jaimevillegas/fusilera-rolo/fusilera 24 canales.kicad_pcb

## KiCad design fusilera 24 canales.kicad_pcb (2026-10-30)

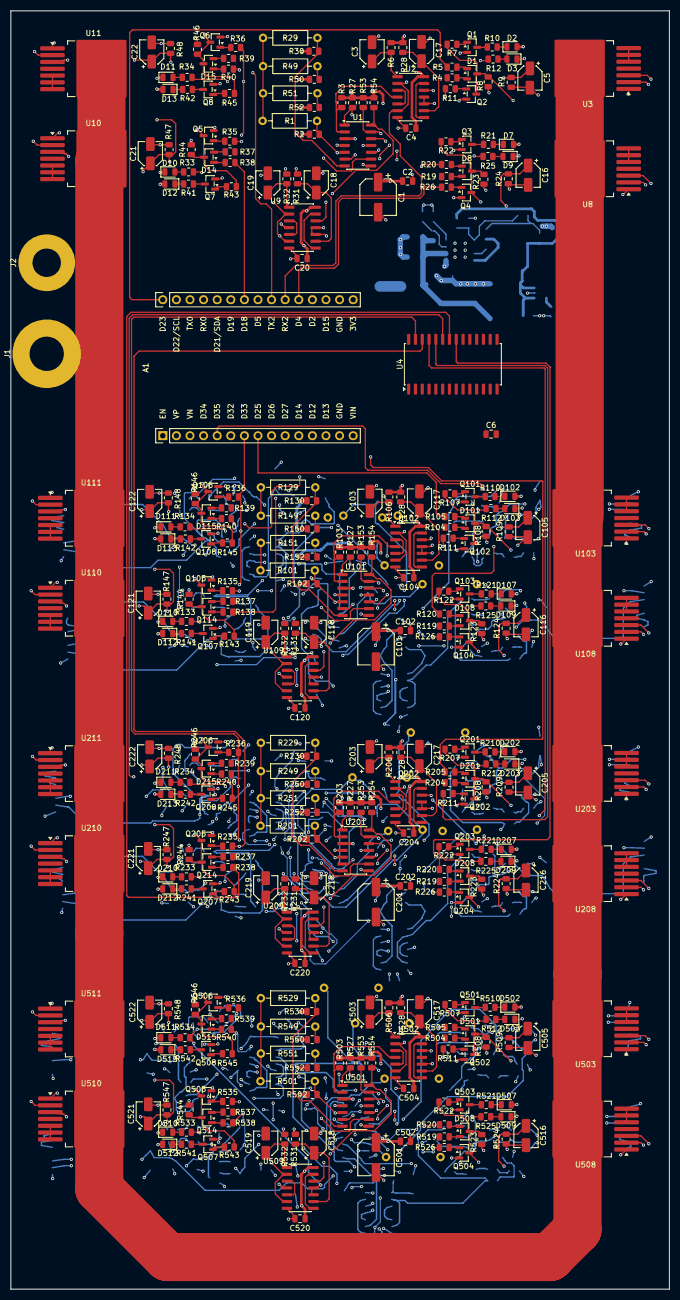
[picture p1: board fusilera 24 canales.kicad_pcb from above]

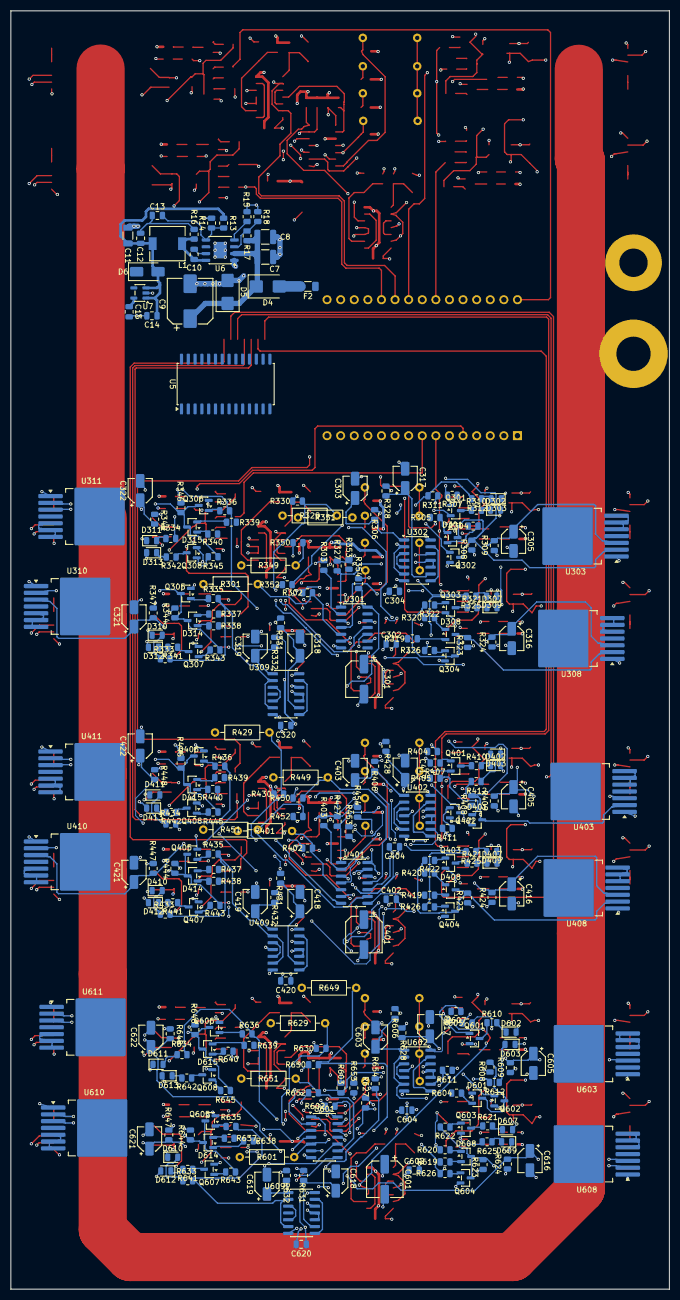
[picture p2: board fusilera 24 canales.kicad_pcb from below]

Board: 4 copper layers, 123.0 x 238.8 mm, 637 parts (284 on the bottom side), 446 nets.

Parts:
A1: ESP32 DevKit V1 30 pines; ESP32_DevKit_30pin_Socket
C1, C101, C201, C301, C401, C501, C601: 100uF 16V; CP_Elec_6.3x5.4
C2, C4, C6, C20, C102, C104, C120, C202, C204, C220, C302, C304, C320, C402, C404, C420, C502, C504, C520, C602, C604, C620: 100nF; C_0805_2012Metric
C3, C5, C16, C17, C18, C19, C21, C22, C103, C105, C116, C117, C118, C119, C121, C122, C203, C205, C216, C217, C218, C219, C221, C222, C303, C305, C316, C317, C318, C319, C321, C322, C403, C405, C416, C417, C418, C419, C421, C422, C503, C505, C516, C517, C518, C519, C521, C522, C603, C605, C616, C617, C618, C619, C621, C622: 1uF 25V; CP_Elec_4x5.4
C7, C8: 2.2uF 100V X7R; C_1210_3225Metric
C9: 47uF 50V; CP_Elec_8x10
C10: 2.2nF 50V X7R; C_0805_2012Metric
C11: 22uF 16V X7R; C_1206_3216Metric
C12: 1nF; C_0805_2012Metric
C13: 82pF C0G; C_0805_2012Metric
C14, C15: 1uF; C_0805_2012Metric
D1, D8, D14, D15, D101, D108, D114, D115, D201, D208, D214, D215, D301, D308, D314, D315, D401, D408, D414, D415, D501, D508, D514, D515, D601, D608, D614, D615: BAT54C; SOT-23
D2, D7, D12, D13, D102, D107, D112, D113, D202, D207, D212, D213, D302, D307, D312, D313, D402, D407, D412, D413, D502, D507, D512, D513, D602, D607, D612, D613: LED verde; LED_0805_2012Metric
D3, D9, D10, D11, D103, D109, D110, D111, D203, D209, D210, D211, D303, D309, D310, D311, D403, D409, D410, D411, D503, D509, D510, D511, D603, D609, D610, D611: LED rojo; LED_0805_2012Metric
D4: SS36; D_SMB
D5: SMBJ; D_SMB
D6: Schottky 1A (SS14); D_SMA
F2: 2A; Fuse_1206_3216Metric
J1: +12V borne M6; MountingHole_6.4mm_M6_Pad
J2: GND borne M5; MountingHole_5.3mm_M5_Pad
L1: 22uH; L_6.3x6.3_H3
Q1, Q2, Q3, Q4, Q5, Q6, Q7, Q8, Q101, Q102, Q103, Q104, Q105, Q106, Q107, Q108, Q201, Q202, Q203, Q204, Q205, Q206, Q207, Q208, Q301, Q302, Q303, Q304, Q305, Q306, Q307, Q308, Q401, Q402, Q403, Q404, Q405, Q406, Q407, Q408, Q501, Q502, Q503, Q504, Q505, Q506, Q507, Q508, Q601, Q602, Q603, Q604, Q605, Q606, Q607, Q608: MMBT2222A; SOT-23
R1, R29, R49, R51, R101, R129, R149, R151, R201, R229, R249, R251, R301, R329, R349, R351, R401, R429, R449, R451, R501, R529, R549, R551, R601, R629, R649, R651: umbral; R_Axial_DIN0207_L6.3mm_D2.5mm_P10.16mm_Horizontal
R2, R3, R6, R27, R28, R30, R31, R32, R50, R52, R53, R54, R102, R103, R106, R127, R128, R130, R131, R132, R150, R152, R153, R154, R202, R203, R206, R227, R228, R230, R231, R232, R250, R252, R253, R254, R302, R303, R306, R327, R328, R330, R331, R332, R350, R352, R353, R354, R402, R403, R406, R427, R428, R430, R431, R432, R450, R452, R453, R454, R502, R503, R506, R527, R528, R530, R531, R532, R550, R552, R553, R554, R602, R603, R606, R627, R628, R630, R631, R632, R650, R652, R653, R654: 10k; R_0805_2012Metric
R4, R5, R11, R19, R20, R26, R35, R36, R37, R38, R39, R40, R104, R105, R111, R119, R120, R126, R135, R136, R137, R138, R139, R140, R204, R205, R211, R219, R220, R226, R235, R236, R237, R238, R239, R240, R304, R305, R311, R319, R320, R326, R335, R336, R337, R338, R339, R340, R404, R405, R411, R419, R420, R426, R435, R436, R437, R438, R439, R440, R504, R505, R511, R519, R520, R526, R535, R536, R537, R538, R539, R540, R604, R605, R611, R619, R620, R626, R635, R636, R637, R638, R639, R640: 4.7k; R_0805_2012Metric
R7, R8, R22, R23, R43, R44, R45, R46, R107, R108, R122, R123, R143, R144, R145, R146, R207, R208, R222, R223, R243, R244, R245, R246, R307, R308, R322, R323, R343, R344, R345, R346, R407, R408, R422, R423, R443, R444, R445, R446, R507, R508, R522, R523, R543, R544, R545, R546, R607, R608, R622, R623, R643, R644, R645, R646: 100k; R_0805_2012Metric
R9, R12, R24, R25, R33, R34, R47, R48, R109, R112, R124, R125, R133, R134, R147, R148, R209, R212, R224, R225, R233, R234, R247, R248, R309, R312, R324, R325, R333, R334, R347, R348, R409, R412, R424, R425, R433, R434, R447, R448, R509, R512, R524, R525, R533, R534, R547, R548, R609, R612, R624, R625, R633, R634, R647, R648: 1k; R_0805_2012Metric
R10, R21, R41, R42, R110, R121, R141, R142, R210, R221, R241, R242, R310, R321, R341, R342, R410, R421, R441, R442, R510, R521, R541, R542, R610, R621, R641, R642: 2.2k; R_0805_2012Metric
R13: 301k; R_0805_2012Metric
R14: 95.3k; R_0805_2012Metric
R15: 31.6k; R_0805_2012Metric
R16: 390k; R_0805_2012Metric
R17: 1M; R_0805_2012Metric
R18: 270k; R_0805_2012Metric
U1, U101, U201, U301, U401, U501, U601: LM339D; SOIC-14_3.9x8.7mm_P1.27mm
U2, U9, U102, U109, U202, U209, U302, U309, U402, U409, U502, U509, U602, U609: 74HC132D; SOIC-14_3.9x8.7mm_P1.27mm
U3, U8, U10, U11, U103, U108, U110, U111, U203, U208, U210, U211, U303, U308, U310, U311, U403, U408, U410, U411, U503, U508, U510, U511, U603, U608, U610, U611: BTS50010-1TAD; TO-263-7_TabPin4
U4, U5: MCP23017-E/SO; SOIC-28W_7.5x17.9mm_P1.27mm
U6: LM5164DDA; HSOP-8-1EP_3.9x4.9mm_P1.27mm_EP2.41x3.1mm
U7: AP2112K-3.3; SOT-23-5

Connections:
+3.3V: C1.1, C2.1, C4.1, C20.1, C101.1, C102.1, C104.1, C120.1, C201.1, C202.1, C204.1, C220.1, C301.1, C302.1, C304.1, C320.1, C401.1, C402.1, C404.1, C420.1, C501.1, C502.1, C504.1, C520.1, C601.1, C602.1, C604.1, C620.1, D2.2 (A), D7.2 (A), D12.2 (A), D13.2 (A), D102.2 (A), D107.2 (A), D112.2 (A), D113.2 (A), D202.2 (A), D207.2 (A), D212.2 (A), D213.2 (A), D302.2 (A), D307.2 (A), D312.2 (A), D313.2 (A), D402.2 (A), D407.2 (A), D412.2 (A), D413.2 (A), D502.2 (A), D507.2 (A), D512.2 (A), D513.2 (A), D602.2 (A), D607.2 (A), D612.2 (A), D613.2 (A), R2.1, R3.2, R6.2, R27.2, R28.2, R30.1, R31.2, R32.2, R50.1, R52.1, R53.2, R54.2, R102.1, R103.2, R106.2, R127.2, R128.2, R130.1, R131.2, R132.2, R150.1, R152.1, R153.2, R154.2, R202.1, R203.2, R206.2, R227.2, R228.2, R230.1, R231.2, R232.2, R250.1, R252.1, R253.2, R254.2, R302.1, R303.2, R306.2, R327.2, R328.2, R330.1, R331.2, R332.2, R350.1, R352.1, R353.2, R354.2, R402.1, R403.2, R406.2, R427.2, R428.2, R430.1, R431.2, R432.2, R440.2, R450.1, R452.1, R453.2, R454.2, R502.1, R503.2, R505.2, R506.2, R520.2, R527.2, R528.2, R530.1, R531.2, R532.2, R538.2, R540.2, R550.1, R552.1, R553.2, R554.2, R602.1, R603.2, R605.2, R606.2, R620.2, R627.2, R628.2, R630.1, R631.2, R632.2, R638.2, R640.2, R650.1, R652.1, R653.2, R654.2, U1.3 (V+), U2.14 (VCC), U9.14 (VCC), U101.3 (V+), U102.14 (VCC), U109.14 (VCC), U201.3 (V+), U202.14 (VCC), U209.14 (VCC), U301.3 (V+), U302.14 (VCC), U309.14 (VCC), U401.3 (V+), U402.14 (VCC), U409.14 (VCC), U501.3 (V+), U502.14 (VCC), U509.14 (VCC), U601.3 (V+), U602.14 (VCC), U609.14 (VCC)
+12V: U3.4 (Vbb), U8.4 (Vbb), U10.4 (Vbb), U11.4 (Vbb), U103.4 (Vbb), U108.4 (Vbb), U110.4 (Vbb), U111.4 (Vbb), U203.4 (Vbb), U208.4 (Vbb), U210.4 (Vbb), U211.4 (Vbb), U303.4 (Vbb), U308.4 (Vbb), U310.4 (Vbb), U311.4 (Vbb), U403.4 (Vbb), U408.4 (Vbb), U410.4 (Vbb), U411.4 (Vbb), U503.4 (Vbb), U508.4 (Vbb), U510.4 (Vbb), U511.4 (Vbb), U603.4 (Vbb), U608.4 (Vbb), U610.4 (Vbb), U611.4 (Vbb)
/Celda1/OUT1: U3.5 (OUT), U3.6 (OUT), U3.7 (OUT)
/Celda1/OUT2: U8.5 (OUT), U8.6 (OUT), U8.7 (OUT)
/Celda1/OUT3: U10.5 (OUT), U10.6 (OUT), U10.7 (OUT)
/Celda1/OUT4: U11.5 (OUT), U11.6 (OUT), U11.7 (OUT)
/Celda2/OUT1: U103.5 (OUT), U103.6 (OUT), U103.7 (OUT)
/Celda2/OUT2: U108.5 (OUT), U108.6 (OUT), U108.7 (OUT)
/Celda2/OUT3: U110.5 (OUT), U110.6 (OUT), U110.7 (OUT)
/Celda2/OUT4: U111.5 (OUT), U111.6 (OUT), U111.7 (OUT)
/Celda3/OUT1: U203.5 (OUT), U203.6 (OUT), U203.7 (OUT)
/Celda3/OUT2: U208.5 (OUT), U208.6 (OUT), U208.7 (OUT)
/Celda3/OUT3: U210.5 (OUT), U210.6 (OUT), U210.7 (OUT)
/Celda3/OUT4: U211.5 (OUT), U211.6 (OUT), U211.7 (OUT)
/Celda4/FALLA1: R311.2, R312.1, U302.2, U302.6
/Celda4/FALLA2: R325.1, R326.2, U302.10, U302.11
/Celda4/FALLA3: R333.1, R335.2, U309.2, U309.6
/Celda4/FALLA4: R334.1, R336.2, U309.10, U309.11
/Celda4/OUT1: U303.5 (OUT), U303.6 (OUT), U303.7 (OUT)
/Celda4/OUT2: U308.5 (OUT), U308.6 (OUT), U308.7 (OUT)
/Celda4/OUT3: U310.5 (OUT), U310.6 (OUT), U310.7 (OUT)
/Celda4/OUT4: U311.5 (OUT), U311.6 (OUT), U311.7 (OUT)
/Celda5/FALLA1: R411.2, R412.1, U402.2, U402.6
/Celda5/FALLA2: R425.1, R426.2, U402.10, U402.11
/Celda5/FALLA3: R433.1, R435.2, U409.2, U409.6
/Celda5/FALLA4: R434.1, R436.2, U409.10, U409.11
/Celda5/OUT1: U403.5 (OUT), U403.6 (OUT), U403.7 (OUT)
/Celda5/OUT2: U408.5 (OUT), U408.6 (OUT), U408.7 (OUT)
/Celda5/OUT3: U410.5 (OUT), U410.6 (OUT), U410.7 (OUT)
/Celda5/OUT4: U411.5 (OUT), U411.6 (OUT), U411.7 (OUT)
/Celda6/FALLA1: R511.2, R512.1, U502.2, U502.6
/Celda6/FALLA2: R525.1, R526.2, U502.10, U502.11
/Celda6/FALLA3: R533.1, R535.2, U509.2, U509.6
/Celda6/FALLA4: R534.1, R536.2, U509.10, U509.11
/Celda6/OUT1: U503.5 (OUT), U503.6 (OUT), U503.7 (OUT)
/Celda6/OUT2: U508.5 (OUT), U508.6 (OUT), U508.7 (OUT)
/Celda6/OUT3: U510.5 (OUT), U510.6 (OUT), U510.7 (OUT)
/Celda6/OUT4: U511.5 (OUT), U511.6 (OUT), U511.7 (OUT)
/Celda7/FALLA1: R611.2, R612.1, U602.2, U602.6
/Celda7/FALLA2: R625.1, R626.2, U602.10, U602.11
/Celda7/FALLA3: R633.1, R635.2, U609.2, U609.6
/Celda7/FALLA4: R634.1, R636.2, U609.10, U609.11
/Celda7/OUT1: U603.5 (OUT), U603.6 (OUT), U603.7 (OUT)
/Celda7/OUT2: U608.5 (OUT), U608.6 (OUT), U608.7 (OUT)
/Celda7/OUT3: U610.5 (OUT), U610.6 (OUT), U610.7 (OUT)
/Celda7/OUT4: U611.5 (OUT), U611.6 (OUT), U611.7 (OUT)
/D4: A1.26 (D4), R25.1, R26.2, U2.10, U2.11
/D13: A1.13 (D13), R205.2
/D14: A1.11 (D14), R140.2
/D18: A1.22 (D18), R38.2
/D19: A1.21 (D19), R20.2
/D23: A1.16 (D23), R5.2
/D25: A1.8 (D25), R105.2
/D26: A1.9 (D26), R120.2
/D27: A1.10 (D27), R138.2
/D32: A1.6 (D32), R133.1, R135.2, U109.2, U109.6
/D33: A1.7 (D33), R134.1, R136.2, U109.10, U109.11
/D34: A1.4 (D34), R111.2, R112.1, U102.2, U102.6
/D35: A1.5 (D35), R125.1, R126.2, U102.10, U102.11
/RX2: A1.25 (RX2/GPIO16), R11.2, R12.1, U2.2, U2.6
/TX2: A1.24 (TX2/GPIO17), R40.2
/U4-GPA0: R220.2, U4.21 (GPA0)
/U4-GPA1: R238.2, U4.22 (GPA1)
/U4-GPA2: R240.2, U4.23 (GPA2)
/U4-GPA3: R211.2, R212.1, U4.24 (GPA3), U202.2, U202.6
/U4-GPA4: R225.1, R226.2, U4.25 (GPA4), U202.10, U202.11
/U4-GPA5: R233.1, R235.2, U4.26 (GPA5), U209.2, U209.6
/U4-GPA6: R234.1, R236.2, U4.27 (GPA6), U209.10, U209.11
/V3V3_OUT: C15.1, U7.5 (VOUT)
/VBB: F2.1, J1.1 (Pin_1_1)
/VN: A1.3 (VN/GPIO39), R34.1, R36.2, U9.10, U9.11
/VP: A1.2 (VP/GPIO36), R33.1, R35.2, U9.2, U9.6
GND: C1.2, C2.2, C3.2, C4.2, C5.2, C7.2, C8.2, C9.2, C11.2, C14.2, C15.2, C16.2, C17.2, C18.2, C19.2, C20.2, C21.2, C22.2, C101.2, C102.2, C103.2, C104.2, C105.2, C116.2, C117.2, C118.2, C119.2, C120.2, C121.2, C122.2, C201.2, C202.2, C203.2, C204.2, C205.2, C216.2, C217.2, C218.2, C219.2, C220.2, C221.2, C222.2, C301.2, C302.2, C303.2, C304.2, C305.2, C316.2, C317.2, C318.2, C319.2, C320.2, C321.2, C322.2, C401.2, C402.2, C403.2, C404.2, C405.2, C416.2, C417.2, C418.2, C419.2, C420.2, C421.2, C422.2, C501.2, C502.2, C503.2, C504.2, C505.2, C516.2, C517.2, C518.2, C519.2, C520.2, C521.2, C522.2, C601.2, C602.2, C603.2, C604.2, C605.2, C616.2, C617.2, C618.2, C619.2, C620.2, C621.2, C622.2, D3.1 (K), D5.2 (A), D9.1 (K), D10.1 (K), D11.1 (K), D103.1 (K), D109.1 (K), D110.1 (K), D111.1 (K), D203.1 (K), D209.1 (K), D210.1 (K), D211.1 (K), D303.1 (K), D309.1 (K), D310.1 (K), D311.1 (K), D403.1 (K), D409.1 (K), D410.1 (K), D411.1 (K), D503.1 (K), D509.1 (K), D510.1 (K), D511.1 (K), D603.1 (K), D609.1 (K), D610.1 (K), D611.1 (K), J2.1 (Pin_1_1), Q1.2 (E), Q2.2 (E), Q3.2 (E), Q4.2 (E), Q5.2 (E), Q6.2 (E), Q7.2 (E), Q8.2 (E), Q101.2 (E), Q102.2 (E), Q103.2 (E), Q104.2 (E), Q105.2 (E), Q106.2 (E), Q107.2 (E), Q108.2 (E), Q201.2 (E), Q202.2 (E), Q203.2 (E), Q204.2 (E), Q205.2 (E), Q206.2 (E), Q207.2 (E), Q208.2 (E), Q301.2 (E), Q302.2 (E), Q303.2 (E), Q304.2 (E), Q305.2 (E), Q306.2 (E), Q307.2 (E), Q308.2 (E), Q401.2 (E), Q402.2 (E), Q403.2 (E), Q404.2 (E), Q405.2 (E), Q406.2 (E), Q407.2 (E), Q408.2 (E), Q501.2 (E), Q502.2 (E), Q503.2 (E), Q504.2 (E), Q505.2 (E), Q506.2 (E), Q507.2 (E), Q508.2 (E), Q601.2 (E), Q602.2 (E), Q603.2 (E), Q604.2 (E), Q605.2 (E), Q606.2 (E), Q607.2 (E), Q608.2 (E), R1.1, R8.2, R9.2, R14.2, R15.2, R18.2, R23.2, R24.2, R29.1, R44.2, R46.2, R47.2, R48.2, R49.1, R51.1, R101.1, R108.2, R109.2, R123.2, R124.2, R129.1, R144.2, R146.2, R147.2, R148.2, R149.1, R151.1, R201.1, R208.2, R209.2, R223.2, R224.2, R229.1, R244.2, R246.2, R247.2, R248.2, R249.1, R251.1, R301.1, R308.2, R309.2, R323.2, R324.2, R329.1, R344.2, R346.2, R347.2, R348.2, R349.1, R351.1, R401.1, R408.2, R409.2, R423.2, R424.2, R429.1, R444.2, R446.2, R447.2, R448.2, R449.1, R451.1, R501.1, R508.2, R509.2, R523.2, R524.2, R529.1, R544.2, R546.2, R547.2, R548.2, R549.1, R551.1, R601.1, R608.2, R609.2, R623.2, R624.2, R629.1, R644.2, R646.2, R647.2, R648.2, R649.1, R651.1, U1.12 (V-), U2.7 (GND), U3.1 (GND), U6.1 (GND), U6.9 (EP), U7.2 (GND), U8.1 (GND), U9.7 (GND), U10.1 (GND), U11.1 (GND), U101.12 (V-), U102.7 (GND), U103.1 (GND), U108.1 (GND), U109.7 (GND), U110.1 (GND), U111.1 (GND), U201.12 (V-), U202.7 (GND), U203.1 (GND), U208.1 (GND), U209.7 (GND), U210.1 (GND), U211.1 (GND), U301.12 (V-), U302.7 (GND), U303.1 (GND), U308.1 (GND), U309.7 (GND), U310.1 (GND), U311.1 (GND), U401.12 (V-), U402.7 (GND), U403.1 (GND), U408.1 (GND), U409.7 (GND), U410.1 (GND), U411.1 (GND), U501.12 (V-), U502.7 (GND), U503.1 (GND), U508.1 (GND), U509.7 (GND), U510.1 (GND), U511.1 (GND), U601.12 (V-), U602.7 (GND), U603.1 (GND), U608.1 (GND), U609.7 (GND), U610.1 (GND), U611.1 (GND)
unnamed: C3.1, R6.1, U2.1
unnamed: C12.1, C13.1, R16.2
unnamed: C17.1, R28.1, U2.9
unnamed: C18.1, R31.1, U9.9
unnamed: C19.1, R32.1, U9.1
unnamed: C103.1, R106.1, U102.1
unnamed: C117.1, R128.1, U102.9
unnamed: C118.1, R131.1, U109.9
unnamed: C119.1, R132.1, U109.1
unnamed: C203.1, R206.1, U202.1
unnamed: C217.1, R228.1, U202.9
unnamed: C218.1, R231.1, U209.9
unnamed: C219.1, R232.1, U209.1
unnamed: C303.1, R306.1, U302.1
unnamed: C317.1, R328.1, U302.9
unnamed: C318.1, R331.1, U309.9
unnamed: C319.1, R332.1, U309.1
unnamed: C403.1, R406.1, U402.1
unnamed: C417.1, R428.1, U402.9
unnamed: C418.1, R431.1, U409.9
unnamed: C419.1, R432.1, U409.1
unnamed: C503.1, R506.1, U502.1
unnamed: C517.1, R528.1, U502.9
unnamed: C518.1, R531.1, U509.9
unnamed: C519.1, R532.1, U509.1
unnamed: C603.1, R606.1, U602.1
unnamed: C617.1, R628.1, U602.9
unnamed: C618.1, R631.1, U609.9
unnamed: C619.1, R632.1, U609.1
unnamed: D1.1, R5.1
unnamed: D1.2, R4.2
unnamed: D2.1 (K), R10.2
unnamed: D3.2 (A), R12.2
unnamed: D4.2 (A), F2.2
unnamed: C7.1, C8.1, C9.1, D4.1 (K), D5.1 (K), R17.1, U6.2 (VIN)
unnamed: C11.1, C12.2, C14.1, D6.2 (A), L1.2, R13.1, U7.1 (VIN), U7.3 (EN)
unnamed: D7.1 (K), R21.2
unnamed: D8.1, R20.1
unnamed: D8.2, R19.2
unnamed: D9.2 (A), R25.2
unnamed: D10.2 (A), R33.2
unnamed: D11.2 (A), R34.2
unnamed: D12.1 (K), R41.2
unnamed: D13.1 (K), R42.2
unnamed: D14.1, R38.1
unnamed: D14.2, R37.2
unnamed: D15.1, R40.1
unnamed: D15.2, R39.2
unnamed: D101.1, R105.1
unnamed: D101.2, R104.2
unnamed: D102.1 (K), R110.2
unnamed: D103.2 (A), R112.2
unnamed: D107.1 (K), R121.2
unnamed: D108.1, R120.1
unnamed: D108.2, R119.2
unnamed: D109.2 (A), R125.2
unnamed: D110.2 (A), R133.2
unnamed: D111.2 (A), R134.2
unnamed: D112.1 (K), R141.2
unnamed: D113.1 (K), R142.2
unnamed: D114.1, R138.1
unnamed: D114.2, R137.2
unnamed: D115.1, R140.1
unnamed: D115.2, R139.2
unnamed: D201.1, R205.1
unnamed: D201.2, R204.2
unnamed: D202.1 (K), R210.2
unnamed: D203.2 (A), R212.2
unnamed: D207.1 (K), R221.2
unnamed: D208.1, R220.1
unnamed: D208.2, R219.2
unnamed: D209.2 (A), R225.2
unnamed: D210.2 (A), R233.2
unnamed: D211.2 (A), R234.2
unnamed: D212.1 (K), R241.2
unnamed: D213.1 (K), R242.2
unnamed: D214.1, R238.1
unnamed: D214.2, R237.2
unnamed: D215.1, R240.1
unnamed: D215.2, R239.2
unnamed: D301.1, R305.1
unnamed: D301.2, R304.2
unnamed: D302.1 (K), R310.2
unnamed: D303.2 (A), R312.2
unnamed: D307.1 (K), R321.2
unnamed: D308.1, R320.1
unnamed: D308.2, R319.2
unnamed: D309.2 (A), R325.2
unnamed: D310.2 (A), R333.2
unnamed: D311.2 (A), R334.2
unnamed: D312.1 (K), R341.2
unnamed: D313.1 (K), R342.2
unnamed: D314.1, R338.1
unnamed: D314.2, R337.2
unnamed: D315.1, R340.1
unnamed: D315.2, R339.2
unnamed: D401.1, R405.1
unnamed: D401.2, R404.2
unnamed: D402.1 (K), R410.2
unnamed: D403.2 (A), R412.2
unnamed: D407.1 (K), R421.2
unnamed: D408.1, R420.1
unnamed: D408.2, R419.2
unnamed: D409.2 (A), R425.2
unnamed: D410.2 (A), R433.2
unnamed: D411.2 (A), R434.2
unnamed: D412.1 (K), R441.2
unnamed: D413.1 (K), R442.2
unnamed: D414.1, R438.1
unnamed: D414.2, R437.2
unnamed: D415.1, R440.1
unnamed: D415.2, R439.2
unnamed: D501.1, R505.1
unnamed: D501.2, R504.2
unnamed: D502.1 (K), R510.2
unnamed: D503.2 (A), R512.2
unnamed: D507.1 (K), R521.2
unnamed: D508.1, R520.1
unnamed: D508.2, R519.2
unnamed: D509.2 (A), R525.2
unnamed: D510.2 (A), R533.2
unnamed: D511.2 (A), R534.2
unnamed: D512.1 (K), R541.2
unnamed: D513.1 (K), R542.2
unnamed: D514.1, R538.1
unnamed: D514.2, R537.2
unnamed: D515.1, R540.1
unnamed: D515.2, R539.2
unnamed: D601.1, R605.1
unnamed: D601.2, R604.2
unnamed: D602.1 (K), R610.2
unnamed: D603.2 (A), R612.2
unnamed: D607.1 (K), R621.2
unnamed: D608.1, R620.1
unnamed: D608.2, R619.2
unnamed: D609.2 (A), R625.2
unnamed: D610.2 (A), R633.2
unnamed: D611.2 (A), R634.2
unnamed: D612.1 (K), R641.2
unnamed: D613.1 (K), R642.2
unnamed: D614.1, R638.1
unnamed: D614.2, R637.2
unnamed: D615.1, R640.1
unnamed: D615.2, R639.2
unnamed: Q1.1 (B), R7.1
unnamed: Q1.3 (C), R10.1
unnamed: Q2.1 (B), R11.1
unnamed: D1.3, Q2.3 (C), R7.2, R8.1, U3.2 (IN)
unnamed: Q3.1 (B), R22.1
unnamed: Q3.3 (C), R21.1
unnamed: Q4.1 (B), R26.1
unnamed: D8.3, Q4.3 (C), R22.2, R23.1, U8.2 (IN)
unnamed: Q5.1 (B), R35.1
unnamed: D14.3, Q5.3 (C), R43.2, R44.1, U10.2 (IN)
unnamed: Q6.1 (B), R36.1
unnamed: D15.3, Q6.3 (C), R45.2, R46.1, U11.2 (IN)
unnamed: Q7.1 (B), R43.1
unnamed: Q7.3 (C), R41.1
unnamed: Q8.1 (B), R45.1
unnamed: Q8.3 (C), R42.1
unnamed: Q101.1 (B), R107.1
unnamed: Q101.3 (C), R110.1
unnamed: Q102.1 (B), R111.1
unnamed: D101.3, Q102.3 (C), R107.2, R108.1, U103.2 (IN)
unnamed: Q103.1 (B), R122.1
unnamed: Q103.3 (C), R121.1
unnamed: Q104.1 (B), R126.1
unnamed: D108.3, Q104.3 (C), R122.2, R123.1, U108.2 (IN)
unnamed: Q105.1 (B), R135.1
unnamed: D114.3, Q105.3 (C), R143.2, R144.1, U110.2 (IN)
unnamed: Q106.1 (B), R136.1
unnamed: D115.3, Q106.3 (C), R145.2, R146.1, U111.2 (IN)
unnamed: Q107.1 (B), R143.1
unnamed: Q107.3 (C), R141.1
unnamed: Q108.1 (B), R145.1
unnamed: Q108.3 (C), R142.1
unnamed: Q201.1 (B), R207.1
unnamed: Q201.3 (C), R210.1
unnamed: Q202.1 (B), R211.1
unnamed: D201.3, Q202.3 (C), R207.2, R208.1, U203.2 (IN)
unnamed: Q203.1 (B), R222.1
unnamed: Q203.3 (C), R221.1
unnamed: Q204.1 (B), R226.1
unnamed: D208.3, Q204.3 (C), R222.2, R223.1, U208.2 (IN)
unnamed: Q205.1 (B), R235.1
unnamed: D214.3, Q205.3 (C), R243.2, R244.1, U210.2 (IN)
unnamed: Q206.1 (B), R236.1
unnamed: D215.3, Q206.3 (C), R245.2, R246.1, U211.2 (IN)
unnamed: Q207.1 (B), R243.1
unnamed: Q207.3 (C), R241.1
unnamed: Q208.1 (B), R245.1
unnamed: Q208.3 (C), R242.1
unnamed: Q301.1 (B), R307.1
unnamed: Q301.3 (C), R310.1
unnamed: Q302.1 (B), R311.1
unnamed: D301.3, Q302.3 (C), R307.2, R308.1, U303.2 (IN)
unnamed: Q303.1 (B), R322.1
unnamed: Q303.3 (C), R321.1
unnamed: Q304.1 (B), R326.1
unnamed: D308.3, Q304.3 (C), R322.2, R323.1, U308.2 (IN)
unnamed: Q305.1 (B), R335.1
unnamed: D314.3, Q305.3 (C), R343.2, R344.1, U310.2 (IN)
unnamed: Q306.1 (B), R336.1
unnamed: D315.3, Q306.3 (C), R345.2, R346.1, U311.2 (IN)
unnamed: Q307.1 (B), R343.1
unnamed: Q307.3 (C), R341.1
unnamed: Q308.1 (B), R345.1
unnamed: Q308.3 (C), R342.1
unnamed: Q401.1 (B), R407.1
unnamed: Q401.3 (C), R410.1
unnamed: Q402.1 (B), R411.1
unnamed: D401.3, Q402.3 (C), R407.2, R408.1, U403.2 (IN)
unnamed: Q403.1 (B), R422.1
unnamed: Q403.3 (C), R421.1
unnamed: Q404.1 (B), R426.1
unnamed: D408.3, Q404.3 (C), R422.2, R423.1, U408.2 (IN)
unnamed: Q405.1 (B), R435.1
unnamed: D414.3, Q405.3 (C), R443.2, R444.1, U410.2 (IN)
unnamed: Q406.1 (B), R436.1
unnamed: D415.3, Q406.3 (C), R445.2, R446.1, U411.2 (IN)
unnamed: Q407.1 (B), R443.1
unnamed: Q407.3 (C), R441.1
unnamed: Q408.1 (B), R445.1
unnamed: Q408.3 (C), R442.1
unnamed: Q501.1 (B), R507.1
unnamed: Q501.3 (C), R510.1
unnamed: Q502.1 (B), R511.1
unnamed: D501.3, Q502.3 (C), R507.2, R508.1, U503.2 (IN)
unnamed: Q503.1 (B), R522.1
unnamed: Q503.3 (C), R521.1
unnamed: Q504.1 (B), R526.1
unnamed: D508.3, Q504.3 (C), R522.2, R523.1, U508.2 (IN)
unnamed: Q505.1 (B), R535.1
unnamed: D514.3, Q505.3 (C), R543.2, R544.1, U510.2 (IN)
unnamed: Q506.1 (B), R536.1
unnamed: D515.3, Q506.3 (C), R545.2, R546.1, U511.2 (IN)
unnamed: Q507.1 (B), R543.1
unnamed: Q507.3 (C), R541.1
unnamed: Q508.1 (B), R545.1
unnamed: Q508.3 (C), R542.1
unnamed: Q601.1 (B), R607.1
unnamed: Q601.3 (C), R610.1
unnamed: Q602.1 (B), R611.1
unnamed: D601.3, Q602.3 (C), R607.2, R608.1, U603.2 (IN)
unnamed: Q603.1 (B), R622.1
unnamed: Q603.3 (C), R621.1
unnamed: Q604.1 (B), R626.1
unnamed: D608.3, Q604.3 (C), R622.2, R623.1, U608.2 (IN)
unnamed: Q605.1 (B), R635.1
unnamed: D614.3, Q605.3 (C), R643.2, R644.1, U610.2 (IN)
unnamed: Q606.1 (B), R636.1
unnamed: D615.3, Q606.3 (C), R645.2, R646.1, U611.2 (IN)
unnamed: Q607.1 (B), R643.1
unnamed: Q607.3 (C), R641.1
unnamed: Q608.1 (B), R645.1
unnamed: Q608.3 (C), R642.1
unnamed: R3.1, U1.2, U2.4
unnamed: R27.1, U1.1, U2.12
unnamed: R53.1, U1.13, U9.4
unnamed: R54.1, U1.14, U9.12
unnamed: R103.1, U101.2, U102.4
unnamed: R127.1, U101.1, U102.12
unnamed: R153.1, U101.13, U109.4
unnamed: R154.1, U101.14, U109.12
unnamed: R203.1, U201.2, U202.4
unnamed: R227.1, U201.1, U202.12
unnamed: R253.1, U201.13, U209.4
unnamed: R254.1, U201.14, U209.12
unnamed: R303.1, U301.2, U302.4
unnamed: R327.1, U301.1, U302.12
unnamed: R353.1, U301.13, U309.4
unnamed: R354.1, U301.14, U309.12
unnamed: R403.1, U401.2, U402.4
unnamed: R427.1, U401.1, U402.12
unnamed: R453.1, U401.13, U409.4
unnamed: R454.1, U401.14, U409.12
unnamed: R503.1, U501.2, U502.4
unnamed: R527.1, U501.1, U502.12
unnamed: R553.1, U501.13, U509.4
unnamed: R554.1, U501.14, U509.12
unnamed: R603.1, U601.2, U602.4
unnamed: R627.1, U601.1, U602.12
unnamed: R653.1, U601.13, U609.4
unnamed: R654.1, U601.14, U609.12
unnamed: R1.2, R2.2, U1.5 (+)
unnamed: C5.1, R9.1, U1.4 (-), U3.3 (IS)
unnamed: R29.2, R30.2, U1.7 (+)
unnamed: C16.1, R24.1, U1.6 (-), U8.3 (IS)
unnamed: R49.2, R50.2, U1.11 (+)
unnamed: R51.2, R52.2, U1.9 (+)
unnamed: U2.3, U2.5
unnamed: U2.8, U2.13
unnamed: C10.1, U6.7 (BST)
unnamed: R17.2, R18.1, U6.3 (EN/UVLO)
unnamed: C13.2, R13.2, R14.1, U6.5 (FB)
unnamed: R15.1, U6.4 (RON)
unnamed: C10.2, L1.1, R16.1, U6.8 (SW)
unnamed: U9.3, U9.5
unnamed: U9.8, U9.13
unnamed: C21.1, R47.1, U1.10 (-), U10.3 (IS)
unnamed: C22.1, R48.1, U1.8 (-), U11.3 (IS)
unnamed: R101.2, R102.2, U101.5 (+)
unnamed: C105.1, R109.1, U101.4 (-), U103.3 (IS)
unnamed: R129.2, R130.2, U101.7 (+)
unnamed: C116.1, R124.1, U101.6 (-), U108.3 (IS)
unnamed: R149.2, R150.2, U101.11 (+)
unnamed: C121.1, R147.1, U101.10 (-), U110.3 (IS)
unnamed: R151.2, R152.2, U101.9 (+)
unnamed: C122.1, R148.1, U101.8 (-), U111.3 (IS)
unnamed: U102.3, U102.5
unnamed: U102.8, U102.13
unnamed: U109.3, U109.5
unnamed: U109.8, U109.13
unnamed: R201.2, R202.2, U201.5 (+)
unnamed: C205.1, R209.1, U201.4 (-), U203.3 (IS)
unnamed: R229.2, R230.2, U201.7 (+)
unnamed: C216.1, R224.1, U201.6 (-), U208.3 (IS)
unnamed: R249.2, R250.2, U201.11 (+)
unnamed: C221.1, R247.1, U201.10 (-), U210.3 (IS)
unnamed: R251.2, R252.2, U201.9 (+)
unnamed: C222.1, R248.1, U201.8 (-), U211.3 (IS)
unnamed: U202.3, U202.5
unnamed: U202.8, U202.13
unnamed: U209.3, U209.5
unnamed: U209.8, U209.13
unnamed: R301.2, R302.2, U301.5 (+)
unnamed: C305.1, R309.1, U301.4 (-), U303.3 (IS)
unnamed: R329.2, R330.2, U301.7 (+)
unnamed: C316.1, R324.1, U301.6 (-), U308.3 (IS)
unnamed: R349.2, R350.2, U301.11 (+)
unnamed: C321.1, R347.1, U301.10 (-), U310.3 (IS)
unnamed: R351.2, R352.2, U301.9 (+)
unnamed: C322.1, R348.1, U301.8 (-), U311.3 (IS)
unnamed: U302.3, U302.5
unnamed: U302.8, U302.13
unnamed: U309.3, U309.5
unnamed: U309.8, U309.13
unnamed: R401.2, R402.2, U401.5 (+)
unnamed: C405.1, R409.1, U401.4 (-), U403.3 (IS)
unnamed: R429.2, R430.2, U401.7 (+)
unnamed: C416.1, R424.1, U401.6 (-), U408.3 (IS)
unnamed: R449.2, R450.2, U401.11 (+)
unnamed: C421.1, R447.1, U401.10 (-), U410.3 (IS)
unnamed: R451.2, R452.2, U401.9 (+)
unnamed: C422.1, R448.1, U401.8 (-), U411.3 (IS)
unnamed: U402.3, U402.5
unnamed: U402.8, U402.13
unnamed: U409.3, U409.5
unnamed: U409.8, U409.13
unnamed: R501.2, R502.2, U501.5 (+)
unnamed: C505.1, R509.1, U501.4 (-), U503.3 (IS)
unnamed: R529.2, R530.2, U501.7 (+)
unnamed: C516.1, R524.1, U501.6 (-), U508.3 (IS)
unnamed: R549.2, R550.2, U501.11 (+)
unnamed: C521.1, R547.1, U501.10 (-), U510.3 (IS)
unnamed: R551.2, R552.2, U501.9 (+)
unnamed: C522.1, R548.1, U501.8 (-), U511.3 (IS)
unnamed: U502.3, U502.5
unnamed: U502.8, U502.13
unnamed: U509.3, U509.5
unnamed: U509.8, U509.13
unnamed: R601.2, R602.2, U601.5 (+)
unnamed: C605.1, R609.1, U601.4 (-), U603.3 (IS)
unnamed: R629.2, R630.2, U601.7 (+)
unnamed: C616.1, R624.1, U601.6 (-), U608.3 (IS)
unnamed: R649.2, R650.2, U601.11 (+)
unnamed: C621.1, R647.1, U601.10 (-), U610.3 (IS)
unnamed: R651.2, R652.2, U601.9 (+)
unnamed: C622.1, R648.1, U601.8 (-), U611.3 (IS)
unnamed: U602.3, U602.5
unnamed: U602.8, U602.13
unnamed: U609.3, U609.5
unnamed: U609.8, U609.13
