jaimevillegas/fusilera-rolo/(commit log)

2026-10-20 Commit inicial: un canal de la fusilera 24 canales
    - Esquemático de un canal: BTS50010-1TAD, comparador LM339 sobre IS,
    latch SR con 74HC132, entrada OR (ESP32/MANUAL) con BAT54C y LEDs testigo.
    - Huellas SMD asignadas (0805, SOIC-14, SOT-23); R12 THT marcada como no ensamblar.
    - CONTEXTO_PROYECTO.md con decisiones, cálculo de umbral y pendientes.
    - .gitignore para respaldos y bloqueos de KiCad.
    [fusilera 24 canales.kicad_pcb, fusilera 24 canales.kicad_sch]
2026-10-21 Añade ESP32 devkit, MCP23017 y biblioteca propia; renumera y documenta
    - Esquemático anotado (referencias renumeradas), desacoples C2/C4 cableados
    y etiquetas de red para reducir cableado.
    - Coloca el MCP23017 (SOIC-28W) y el ESP32 devkit V1 de 30 pines, ambos sin cablear.
    - Biblioteca del proyecto en libs/: símbolo ESP32_DevKit_30pin y huella
    ESP32_DevKit_30pin_Socket (zócalos 2x15, 25,4 mm entre filas), con sym-lib-table
    y fp-lib-table.
    - CONTEXTO_PROYECTO.md regenerado con las referencias actuales y la asignación
    de pines del ESP32 y el MCP23017.
    - CLAUDE.md con las reglas de trabajo del repositorio.
    [fusilera 24 canales.kicad_sch]
2026-10-22 Añade MCP23017 de fallas y bloque de alimentación con LM5164
    - Segundo MCP23017 (U5, 0x21) con su desacople: lee las entradas de falla y
    aporta 2 salidas (GPA7/GPB7 solo salida). Se descarta la lectura analógica.
    - Bloque de alimentación cableado, sin conectar al resto: borne +12V, fusible de
    lógica, diodo de polaridad inversa, TVS, buck 12→5 V con LM5164 (red de
    rizado Tipo 3), diodo hacia el devkit y LDO 5→3,3 V con AP2112K.
    - Puntos de conexión etiquetados: VBB, GND_PWR, VIN_ESP32 y V3V3_OUT.
    - CONTEXTO_PROYECTO.md actualizado: reparto de pines, datos del datasheet del
    BTS, cobre para 40-50 A, decisiones de alimentación y tabla del bloque.
    [fusilera 24 canales.kicad_sch]
2026-10-22 Rutea el bloque de alimentación en el PCB de 4 capas y configura reglas
    - Configura el PCB: stackup de 4 capas de 1,6 mm con cobre exterior de 2 oz,
    reglas de fabricación (0,2 mm, vías 0,6/0,3 mm) y clases de red para 10 A
    continuos (Potencia_12V, Entrada_Logica, Conmutacion, Potencia_5V_3V3).
    - Importa los 53 footprints y rutea el bloque de alimentación en F.Cu
    (46 × 24 mm) siguiendo las reglas de layout del LM5164: CIN a 4,6 mm del VIN,
    divisor de realimentación junto al pin FB, SW a 6,2 mm de L1.
    - Crea el plano de GND en In1 con 32 vías de 0,6/0,3 mm y uniones de 1 mm en
    los condensadores de entrada y salida y en el TVS (3 vías).
    - Cambia la huella de U6 a la versión s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
    [fusilera 24 canales.kicad_pcb, fusilera 24 canales.kicad_sch]
2026-10-22 Convierte los canales en una hoja jerárquica de celda con dos instancias
    - Nueva hoja celda4.kicad_sch (4 canales, 1 LM339 y 2 × 74HC132) instanciada
    como Celda1 y Celda2 en la hoja principal; las referencias de la Celda2 son
    las de la Celda1 más 100.
    - Etiquetas únicas por canal como pines de hoja (ESP32_OUT1-4, MANUAL1-4,
    OUT1-4, FALLA1-4): ya no se unen entre sí las salidas, las entradas ni las
    fallas de distintos canales.
    - Añade los pull-ups de 10 k que faltaban en las salidas de los comparadores de
    los canales 3 y 4 (R53 y R54).
    - Re-vincula en el PCB los 25 footprints existentes de la celda a la Celda1 para
    conservar su colocación.
    - La huella de la ESP32 lleva los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
    [celda4.kicad_sch, fusilera 24 canales.kicad_pcb, fusilera 24 canales.kicad_sch]
2026-10-22 Importa las dos celdas al PCB y avanza el ruteo de la Celda1
    - Importa a la placa los 202 footprints (bloque de alimentación, ESP32, MCP23017
    y las celdas Celda1 y Celda2); paridad con el esquemático sin problemas.
    - Avanza el ruteo: 371 segmentos y 43 vías; el plano de GND de In1 se mantiene.
    - Reubica en el esquemático el grupo del ESP32 y los MCP23017.
    - El DRC sigue marcando el contorno que falta, 260 conexiones por rutear y
    18 avisos de espaciado pendientes de revisar.
    [fusilera 24 canales.kicad_pcb, fusilera 24 canales.kicad_sch]
2026-10-23 Avanza el ruteo de la Celda1 y rehace el plano de GND sobre ella
    Rutea parte de IN/IS en In2, mueve la Celda2 a su propia zona y redibuja el
    plano de GND de In1 para cubrir la Celda1. El plano ya no cubre el bloque de
    poder, por lo que sus vías de GND quedan pendientes de un plano que las una.
    Se actualiza CONTEXTO_PROYECTO.md con el estado del PCB.
    [fusilera 24 canales.kicad_pcb]
2026-10-23 Une GND_PWR con GND y añade el plano de +3,3 V en In2
    Sustituye las tres etiquetas GND_PWR del esquemático raíz por símbolos de
    tierra para que el bloque de poder comparta la red GND con las celdas. El
    plano de In1 pasa a la red GND y se añade el plano de +3,3 V en In2 sobre la
    Celda1. Continúa el ruteo de la Celda1 (más vías y pistas en F.Cu e In2) y se
    actualiza CONTEXTO_PROYECTO.md.
    [fusilera 24 canales.kicad_pcb, fusilera 24 canales.kicad_sch]
2026-10-23 Corrige espaciados de 0,2 mm en la Celda1 y alimenta U1 con un puente en B.Cu
    Separa a 0,25 mm o más las pistas de F.Cu y las vías de In2 que quedaban a
    0,200 mm (FALLA3, FALLA4, R54, R3, U1B+, IS del canal 1 y vías de GND, R27 y
    U1A+), y reordena R27 frente a FALLA1 y U1A- en In2. El pin 3 de U1 estaba en
    una isla del plano de +3,3 V encerrada por pistas de In2; se añade un puente de
    0,5 mm en B.Cu que la une al plano. Se actualiza CONTEXTO_PROYECTO.md.
    [fusilera 24 canales.kicad_pcb]
2026-10-23 Replica la Celda1 en la Celda2 y extiende los planos de GND y +3,3 V
    Copia footprints, pistas y vías de la Celda1 a la Celda2 con la red equivalente
    (87 footprints, 539 pistas, 97 vías). Las celdas quedan una junto a la otra, la
    Celda2 girada 180°, y los planos de In1 e In2 cubren ahora ambas celdas.
    Quedan por resolver la tira de +12 V, las zonas de salida y el contorno. Se
    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
    [fusilera 24 canales.kicad_pcb]
2026-10-23 Añade la Celda3, gira los canales 3 y 4 y rutea los grupos movidos de la Celda1
    Agrega la tercera instancia de la celda al esquemático (referencias +200) y
    pasa sus footprints al PCB. En la Celda1 los canales 3 y 4 quedan girados 180°
    al lado izquierdo con la lógica compartida en el centro, y se rutean con un
    enrutador de rejilla propio IS3, IS4, FALLA3, FALLA4, los umbrales y los
    pull-ups de los comparadores, más las vías de plano de C18, C19, R31 y R32.
    Se documenta la decisión de arquitectura y el riesgo del bus hacia el
    controlador en CONTEXTO_PROYECTO.md.
    [celda4.kicad_sch, fusilera 24 canales.kicad_pcb, fusilera 24 canales.kicad_sch]
2026-10-26 Conecta las celdas con el micro, dibuja el contorno y reubica los bloques
    Cablea en el esquemático raíz las salidas ESP32_OUT y las entradas FALLA de las
    tres celdas a pines de la ESP32 (A1) y del MCP23017 (U4) mediante etiquetas
    locales, de modo que el PCB muestra el ratsnest hacia el controlador. Dibuja el
    contorno de la placa en Edge.Cuts (123 x 191 mm), ajusta los planos de GND y
    +3,3 V a ese contorno y reubica las celdas, el controlador y el bloque de poder.
    Se registra la hoja Celda3 en el proyecto y se actualiza CONTEXTO_PROYECTO.md.
    [celda4.kicad_sch, fusilera 24 canales.kicad_pcb, fusilera 24 canales.kicad_sch]
2026-10-26 Une al plano las islas de +3,3 V de la Celda2 con puentes en B.Cu
    Los pads de U101 pin 3, U102 pin 14 y sus resistencias y condensadores de
    +3,3 V quedaban en islas de In2 encerradas por las pistas del bus hacia el
    controlador, sin conexión física al plano principal (el DRC de KiCad no lo
    detecta). Se añaden dos puentes de 0,5 mm en B.Cu y se anota el hallazgo en
    CONTEXTO_PROYECTO.md.
    [fusilera 24 canales.kicad_pcb]
2026-10-27 Añade las celdas 4 y 5 de la cara inferior como copias volteadas en B.Cu
    Agrega las hojas Celda4 y Celda5 al esquemático raíz (referencias +300 y +400,
    pines sin cablear) y crea sus 87 footprints cada una en B.Cu como imagen en
    espejo de la celda dorada, con 556 pistas y 101 vías, aparcadas bajo el
    contorno. Con las siete celdas previstas (3 en la cara frontal, 4 en la
    inferior) quedan 28 canales: el cuarto canal de la Celda5 y las celdas 6 y 7
    serán las salidas directas. Se documenta el plan en CONTEXTO_PROYECTO.md.
    [celda4.kicad_sch, fusilera 24 canales.kicad_pcb, fusilera 24 canales.kicad_sch]
2026-10-27 Coloca y rutea las celdas 4 y 5 en B.Cu con vías conscientes de todas las capas
    Las huellas de las celdas inferiores se legalizan contra las vías, THT y cobre
    de las celdas de arriba; el ruteo usa B.Cu e In2 con vías solo donde las tres
    capas están libres, sin vías en pad y con 0,3 mm frente al +12 V. Las islas del
    plano +3,3 V que partían las pistas de In2 se unen al plano con puentes.
    Quedan 4 conexiones sin rutear en la Celda4 y las tiras de +12 V inferiores.
    Se documenta el estado y el conflicto del bloque de potencia en CONTEXTO_PROYECTO.md.
    [fusilera 24 canales.kicad_pcb]
2026-10-27 Añade las celdas 6 y 7 (canales directos) y alarga la placa 47,7 mm
    Hojas Celda6 y Celda7 en el esquemático con los canales idénticos a los demás;
    los ESP32_OUT de las 9 salidas directas (canal 4 de la Celda5 y las celdas 6 y 7)
    se amarran a +3,3 V en la raíz. En el PCB se alarga el contorno, los planos y las
    tiras de +12 V; la Celda6 va en el frente como copia de la Celda3 y la Celda7 en B.Cu
    colocada y ruteada con vías libres en todas las capas, con puentes en las islas del
    plano +3,3 V. Quedan 3 conexiones sin rutear en la Celda7 y las uniones de +12 V
    del reverso. Se documenta en CONTEXTO_PROYECTO.md.
    [celda4.kicad_sch, fusilera 24 canales.kicad_pcb, fusilera 24 canales.kicad_sch]
2026-10-30 Actualiza la PCB con los ajustes hechos en KiCad tras las celdas 6 y 7
    Cambios manuales del usuario sobre la placa alargada y ruta de salida de
    Gerber guardada en el proyecto.
    [fusilera 24 canales.kicad_pcb]
